innot/Diag6502rp/docs/dev/6502 Varints.odt

# 6502 Pin Compatible Variants

MOS/Rockwell/Synertek | 6502 | 1 MHz
| 6502A | 2 MHz
| 6502B | 3 MHz
| 6502C | 4 MHz
Atari | Sally (6502C) | 1.8 MHz
WDC | W65C02S | 14 MHz

Ma | | | Pin1 | Pin5 | Pin34 | Pin35 | Pin36
6502 | | | VSS (GND) | N.C. | R/W | N.C. | N.C.
Atari Sally | | | VSS (GND) | N.C. | N.C. | HALT | R/W
WDC65C02S | | | VPB | MLB | R/W | N.C. | BE

BE: Bus Enable input When low A, D and R/W are high impedance (async)

HALT: Halt CPU input When low A, D and R/W are high impedance (async)

MLB: Memory Lock output Low during memory read/modify/write cycles.

VPB: Vector Pull output Low when CPU reads interrupt vector

WDC65C02:

- RDY is bidirectional (low output during WAI instruction)
