innot/Diag6502rp/(list of files, drawings)

Other design files:
hardware/Diag6502rp/freerouting.dsn
hardware/Diag6502rp/temp-freerouting.dsn
