innot/Diag6502rp/hardware/Diag6502rp/Diag6502rp.kicad_pcb

## KiCad design hardware/Diag6502rp/Diag6502rp.kicad_pcb (2025-07-18)

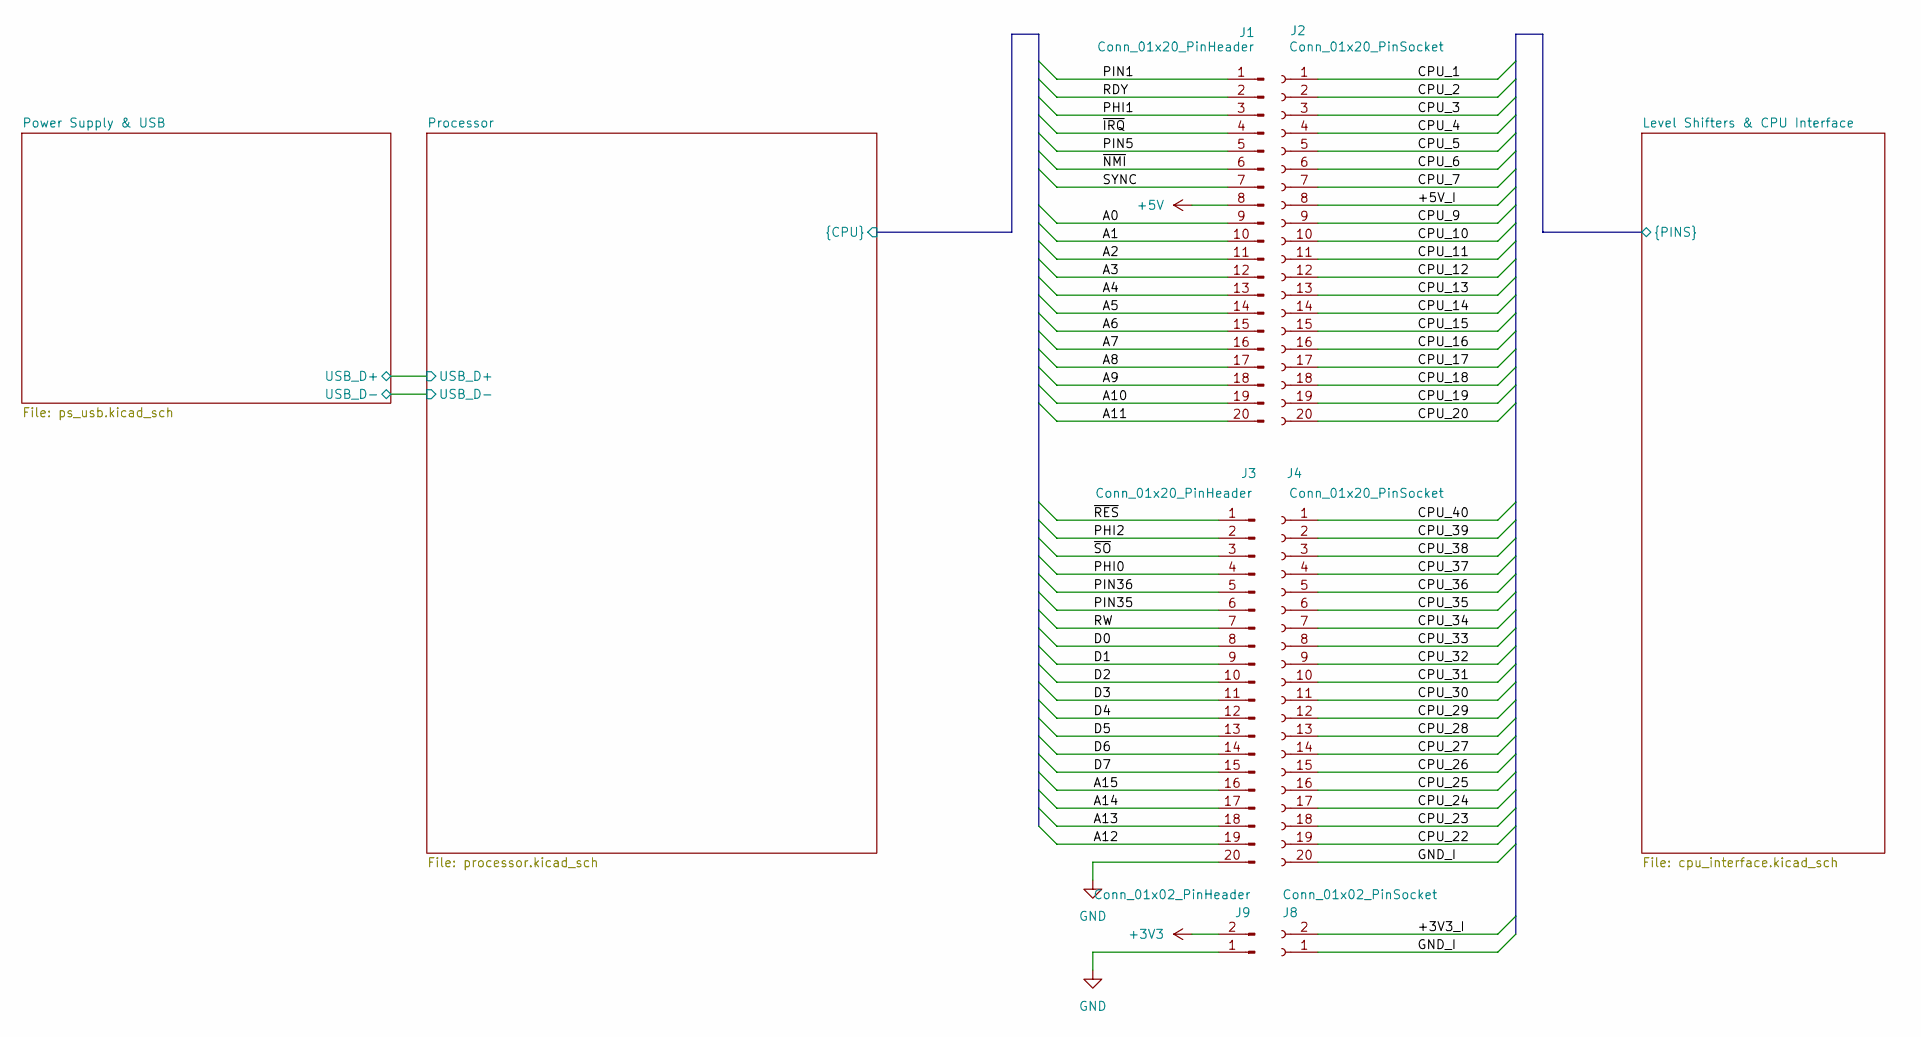
[picture p1: schematic Diag6502rp.kicad_sch]

Parts:
J1, J3: Conn_01x20_PinHeader; PinHeader_1x20_P2.54mm_Vertical; LCSC Part # C50981
J2, J4: Conn_01x20_PinSocket; PinSocket_1x20_P2.54mm_Vertical; LCSC Part # C7499336
J8: Conn_01x02_PinSocket; PinSocket_1x02_P2.54mm_Vertical; LCSC Part # C7499322
J9: Conn_01x02_PinHeader; PinHeader_1x02_P2.54mm_Vertical; LCSC Part # C492401

Connections:
+3V3: J9.2; also elsewhere on the board
+5V: J1.8; also elsewhere on the board
/Level Shifters & CPU Interface/+3V3_I: J8.2; also elsewhere on the board
/Level Shifters & CPU Interface/+5V_I: J2.8; also elsewhere on the board
/Level Shifters & CPU Interface/CPU_1: J2.1; also elsewhere on the board
/Level Shifters & CPU Interface/CPU_2: J2.2; also elsewhere on the board
/Level Shifters & CPU Interface/CPU_3: J2.3; also elsewhere on the board
/Level Shifters & CPU Interface/CPU_4: J2.4; also elsewhere on the board
/Level Shifters & CPU Interface/CPU_5: J2.5; also elsewhere on the board
/Level Shifters & CPU Interface/CPU_6: J2.6; also elsewhere on the board
/Level Shifters & CPU Interface/CPU_7: J2.7; also elsewhere on the board
/Level Shifters & CPU Interface/CPU_9: J2.9; also elsewhere on the board
/Level Shifters & CPU Interface/CPU_10: J2.10; also elsewhere on the board
/Level Shifters & CPU Interface/CPU_11: J2.11; also elsewhere on the board
/Level Shifters & CPU Interface/CPU_12: J2.12; also elsewhere on the board
/Level Shifters & CPU Interface/CPU_13: J2.13; also elsewhere on the board
/Level Shifters & CPU Interface/CPU_14: J2.14; also elsewhere on the board
/Level Shifters & CPU Interface/CPU_15: J2.15; also elsewhere on the board
/Level Shifters & CPU Interface/CPU_16: J2.16; also elsewhere on the board
/Level Shifters & CPU Interface/CPU_17: J2.17; also elsewhere on the board
/Level Shifters & CPU Interface/CPU_18: J2.18; also elsewhere on the board
/Level Shifters & CPU Interface/CPU_19: J2.19; also elsewhere on the board
/Level Shifters & CPU Interface/CPU_20: J2.20; also elsewhere on the board
/Level Shifters & CPU Interface/CPU_22: J4.19; also elsewhere on the board
/Level Shifters & CPU Interface/CPU_23: J4.18; also elsewhere on the board
/Level Shifters & CPU Interface/CPU_24: J4.17; also elsewhere on the board
/Level Shifters & CPU Interface/CPU_25: J4.16; also elsewhere on the board
/Level Shifters & CPU Interface/CPU_26: J4.15; also elsewhere on the board
/Level Shifters & CPU Interface/CPU_27: J4.14; also elsewhere on the board
/Level Shifters & CPU Interface/CPU_28: J4.13; also elsewhere on the board
/Level Shifters & CPU Interface/CPU_29: J4.12; also elsewhere on the board
/Level Shifters & CPU Interface/CPU_30: J4.11; also elsewhere on the board
/Level Shifters & CPU Interface/CPU_31: J4.10; also elsewhere on the board
/Level Shifters & CPU Interface/CPU_32: J4.9; also elsewhere on the board
/Level Shifters & CPU Interface/CPU_33: J4.8; also elsewhere on the board
/Level Shifters & CPU Interface/CPU_34: J4.7; also elsewhere on the board
/Level Shifters & CPU Interface/CPU_35: J4.6; also elsewhere on the board
/Level Shifters & CPU Interface/CPU_36: J4.5; also elsewhere on the board
/Level Shifters & CPU Interface/CPU_37: J4.4; also elsewhere on the board
/Level Shifters & CPU Interface/CPU_38: J4.3; also elsewhere on the board
/Level Shifters & CPU Interface/CPU_39: J4.2; also elsewhere on the board
/Level Shifters & CPU Interface/CPU_40: J4.1; also elsewhere on the board
/Level Shifters & CPU Interface/GND_I: J4.20, J8.1; also elsewhere on the board
/Processor/A0: J1.9; also elsewhere on the board
/Processor/A1: J1.10; also elsewhere on the board
/Processor/A2: J1.11; also elsewhere on the board
/Processor/A3: J1.12; also elsewhere on the board
/Processor/A4: J1.13; also elsewhere on the board
/Processor/A5: J1.14; also elsewhere on the board
/Processor/A6: J1.15; also elsewhere on the board
/Processor/A7: J1.16; also elsewhere on the board
/Processor/A8: J1.17; also elsewhere on the board
/Processor/A9: J1.18; also elsewhere on the board
/Processor/A10: J1.19; also elsewhere on the board
/Processor/A11: J1.20; also elsewhere on the board
/Processor/A12: J3.19; also elsewhere on the board
/Processor/A13: J3.18; also elsewhere on the board
/Processor/A14: J3.17; also elsewhere on the board
/Processor/A15: J3.16; also elsewhere on the board
/Processor/D0: J3.8; also elsewhere on the board
/Processor/D1: J3.9; also elsewhere on the board
/Processor/D2: J3.10; also elsewhere on the board
/Processor/D3: J3.11; also elsewhere on the board
/Processor/D4: J3.12; also elsewhere on the board
/Processor/D5: J3.13; also elsewhere on the board
/Processor/D6: J3.14; also elsewhere on the board
/Processor/D7: J3.15; also elsewhere on the board
/Processor/PHI0: J3.4; also elsewhere on the board
/Processor/PHI1: J1.3; also elsewhere on the board
/Processor/PHI2: J3.2; also elsewhere on the board
/Processor/PIN1: J1.1; also elsewhere on the board
/Processor/PIN5: J1.5; also elsewhere on the board
/Processor/PIN35: J3.6; also elsewhere on the board
/Processor/PIN36: J3.5; also elsewhere on the board
/Processor/RDY: J1.2; also elsewhere on the board
/Processor/RW: J3.7; also elsewhere on the board
/Processor/SYNC: J1.7; also elsewhere on the board
/Processor/~IRQ: J1.4; also elsewhere on the board
/Processor/~NMI: J1.6; also elsewhere on the board
/Processor/~RES: J3.1; also elsewhere on the board
/Processor/~SO: J3.3; also elsewhere on the board
GND: J3.20, J9.1; also elsewhere on the board

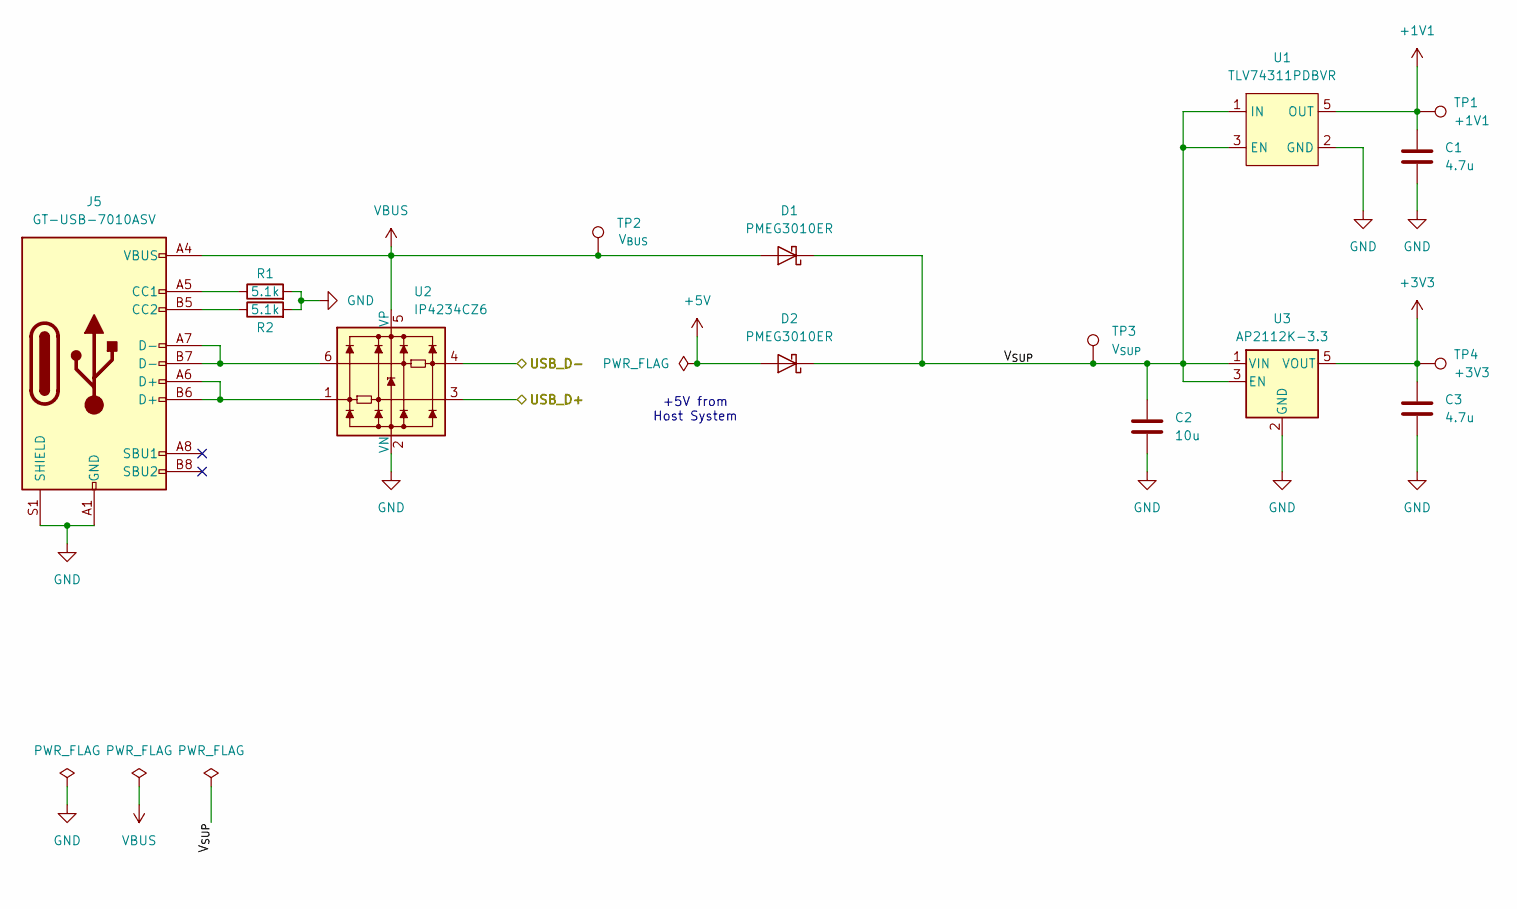
[picture p2: schematic ps_usb.kicad_sch]

Parts:
C1, C3: 4.7u; C_0402_1005Metric; LCSC Part # C23733
C2: 10u; C_0603_1608Metric; LCSC Part # C19702
D1, D2: PMEG3010ER; Nexperia_CFP3_SOD-123W; LCSC Part # C456106
J5: GT-USB-7010ASV; USB_C_Receptacle_G-Switch_GT-USB-7010ASV
R1, R2: 5.1k; R_0402_1005Metric; LCSC Part # C25905
TP1: +1V1; TestPoint_Pad_1.0x1.0mm
TP2: V_{BUS}; TestPoint_Pad_1.0x1.0mm
TP3: V_{SUP}; TestPoint_Pad_1.0x1.0mm
TP4: +3V3; TestPoint_Pad_1.0x1.0mm
U1: TLV74311PDBVR; SOT-23-5; LCSC Part # C485147
U2: IP4234CZ6; SC-74-6_1.55x2.9mm_P0.95mm; LCSC Part # C455086
U3: AP2112K-3.3; SOT-23-5; LCSC Part # C51118

Connections:
+1V1: C1.1, TP1.1, U1.5 (OUT); also elsewhere on the board
+3V3: C3.1, TP4.1, U3.5 (VOUT); also elsewhere on the board
+5V: D2.2 (A); also elsewhere on the board
/Power Supply & USB/V_{SUP}: C2.1, D1.1 (K), D2.1 (K), TP3.1, U1.1 (IN), U1.3 (EN), U3.1 (VIN), U3.3 (EN)
/Processor/USB_D+: U2.3; also elsewhere on the board
/Processor/USB_D-: U2.4; also elsewhere on the board
GND: C1.2, C2.2, C3.2, J5.A1 (GND), J5.A12 (GND), J5.B1 (GND), J5.B12 (GND), J5.S1 (SHIELD), R1.2, R2.2, U1.2 (GND), U2.2 (VN), U3.2 (GND); also elsewhere on the board
unnamed: J5.A5 (CC1), R1.1
unnamed: J5.B5 (CC2), R2.1
unnamed: J5.A6 (D+), J5.B6 (D+), U2.1
unnamed: J5.A7 (D-), J5.B7 (D-), U2.6
VBUS: D1.2 (A), J5.A4 (VBUS), J5.A9 (VBUS), J5.B4 (VBUS), J5.B9 (VBUS), TP2.1, U2.5 (VP)

Notes on the sheet:
+5V from Host System

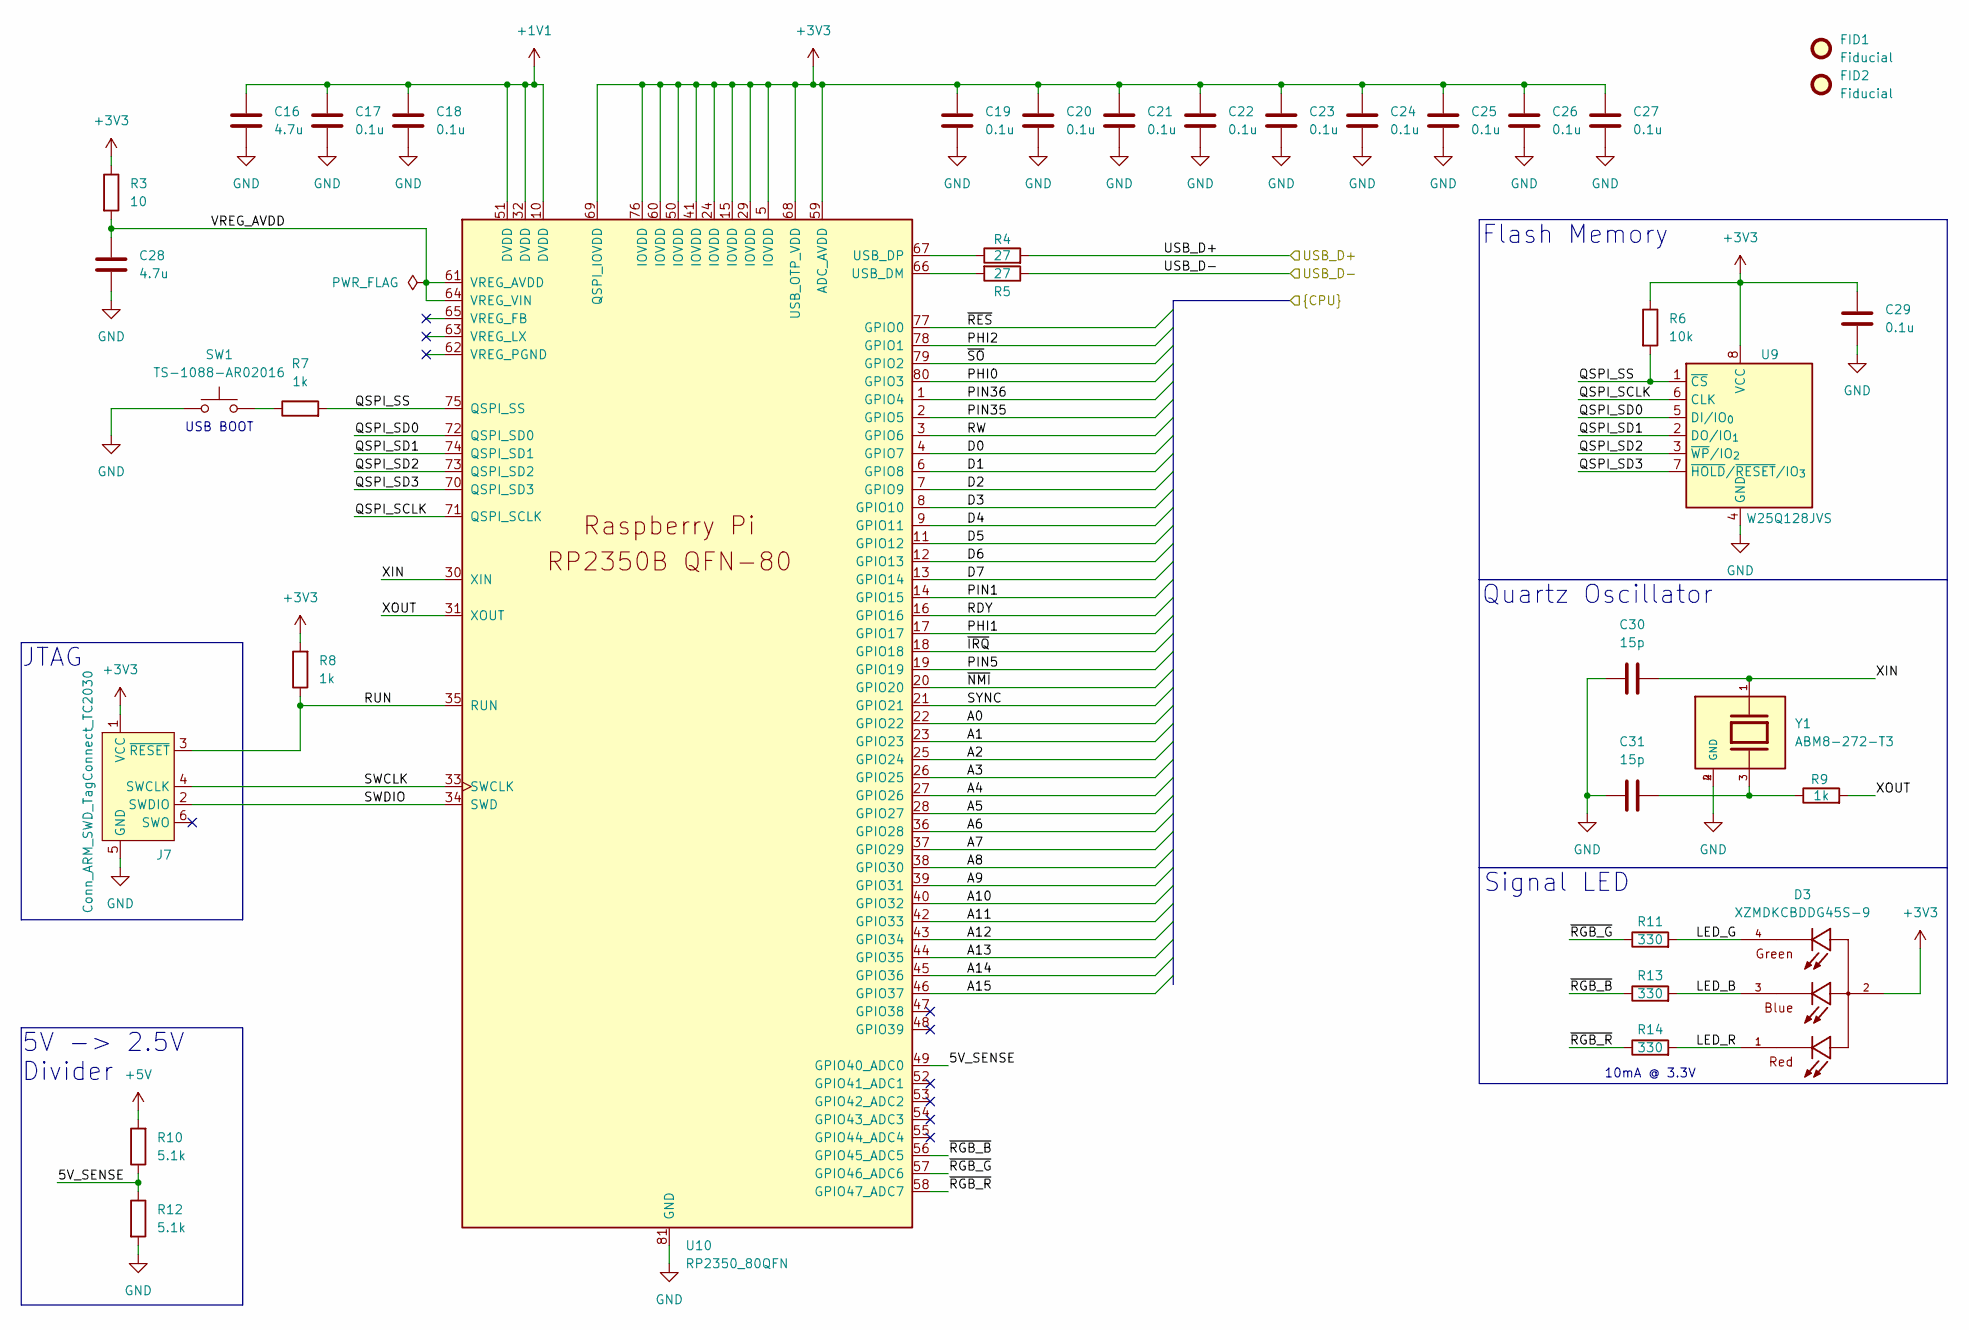
[picture p3: schematic processor.kicad_sch]

Parts:
C16, C28: 4.7u; C_0402_1005Metric; LCSC Part # C23733
C17, C18, C19, C20, C21, C22, C23, C24, C25, C26, C27, C29: 0.1u; C_0402_1005Metric; LCSC Part # C1525
C30, C31: 15p; C_0402_1005Metric; LCSC Part # C1548
D3: XZMDKCBDDG45S-9; LED_XZMDKCBDDG45S-9; PARTREV V11-Z; DigiKey_Part_Number 1497-1257-2-ND
FID1, FID2: Fiducial; Fiducial_1mm_Mask2mm
J7: Conn_ARM_SWD_TagConnect_TC2030; Tag-Connect_TC2030-IDC-FP_2x03_P1.27mm_Vertical
R3: 10; R_0402_1005Metric; LCSC Part # C25077
R4, R5: 27; R_0402_1005Metric; LCSC Part # C138021
R6: 10k; R_0402_1005Metric; LCSC Part # C25744
R7, R8, R9: 1k; R_0402_1005Metric; LCSC Part # C11702
R10, R12: 5.1k; R_0402_1005Metric; LCSC Part # C25905
R11, R13, R14: 330; R_0402_1005Metric; LCSC Part # C25130
SW1: TS-1088-AR02016; TS-1088-xxxxxxx; LCSC Part # C720477
U9: W25Q128JVS; SOIC-8_5.3x5.3mm_P1.27mm; LCSC Part # C97521
U10: RP2350_80QFN; RP2350-QFN-80-1EP_10x10_P0.4mm_EP3.4x3.4mm_ThermalVias; LCSC Part # C42415655
Y1: ABM8-272-T3; XTAL_ABM8-272-T3; PARTREV 07-29-20; LCSC Part # C20625731

Connections:
+1V1: C16.1, C17.1, C18.1, U10.10 (DVDD), U10.32 (DVDD), U10.51 (DVDD); also elsewhere on the board
+3V3: C19.1, C20.1, C21.1, C22.1, C23.1, C24.1, C25.1, C26.1, C27.1, C29.1, D3.2, J7.1 (VCC), R3.1, R6.1, R8.2, U9.8 (VCC), U10.5 (IOVDD), U10.15 (IOVDD), U10.24 (IOVDD), U10.29 (IOVDD), U10.41 (IOVDD), U10.50 (IOVDD), U10.59 (ADC_AVDD), U10.60 (IOVDD), U10.68 (USB_OTP_VDD), U10.69 (QSPI_IOVDD), U10.76 (IOVDD); also elsewhere on the board
+5V: R10.2; also elsewhere on the board
/Processor/5V_SENSE: R10.1, R12.1, U10.49 (GPIO40_ADC0)
/Processor/A0: U10.22 (GPIO22); also elsewhere on the board
/Processor/A1: U10.23 (GPIO23); also elsewhere on the board
/Processor/A2: U10.25 (GPIO24); also elsewhere on the board
/Processor/A3: U10.26 (GPIO25); also elsewhere on the board
/Processor/A4: U10.27 (GPIO26); also elsewhere on the board
/Processor/A5: U10.28 (GPIO27); also elsewhere on the board
/Processor/A6: U10.36 (GPIO28); also elsewhere on the board
/Processor/A7: U10.37 (GPIO29); also elsewhere on the board
/Processor/A8: U10.38 (GPIO30); also elsewhere on the board
/Processor/A9: U10.39 (GPIO31); also elsewhere on the board
/Processor/A10: U10.40 (GPIO32); also elsewhere on the board
/Processor/A11: U10.42 (GPIO33); also elsewhere on the board
/Processor/A12: U10.43 (GPIO34); also elsewhere on the board
/Processor/A13: U10.44 (GPIO35); also elsewhere on the board
/Processor/A14: U10.45 (GPIO36); also elsewhere on the board
/Processor/A15: U10.46 (GPIO37); also elsewhere on the board
/Processor/D0: U10.4 (GPIO7); also elsewhere on the board
/Processor/D1: U10.6 (GPIO8); also elsewhere on the board
/Processor/D2: U10.7 (GPIO9); also elsewhere on the board
/Processor/D3: U10.8 (GPIO10); also elsewhere on the board
/Processor/D4: U10.9 (GPIO11); also elsewhere on the board
/Processor/D5: U10.11 (GPIO12); also elsewhere on the board
/Processor/D6: U10.12 (GPIO13); also elsewhere on the board
/Processor/D7: U10.13 (GPIO14); also elsewhere on the board
/Processor/LED_B: D3.3, R13.2
/Processor/LED_G: D3.4, R11.2
/Processor/LED_R: D3.1, R14.2
/Processor/PHI0: U10.80 (GPIO3); also elsewhere on the board
/Processor/PHI1: U10.17 (GPIO17); also elsewhere on the board
/Processor/PHI2: U10.78 (GPIO1); also elsewhere on the board
/Processor/PIN1: U10.14 (GPIO15); also elsewhere on the board
/Processor/PIN5: U10.19 (GPIO19); also elsewhere on the board
/Processor/PIN35: U10.2 (GPIO5); also elsewhere on the board
/Processor/PIN36: U10.1 (GPIO4); also elsewhere on the board
/Processor/QSPI_SCLK: U9.6 (CLK), U10.71 (QSPI_SCLK)
/Processor/QSPI_SD0: U9.5 (DI/IO_{0}), U10.72 (QSPI_SD0)
/Processor/QSPI_SD1: U9.2 (DO/IO_{1}), U10.74 (QSPI_SD1)
/Processor/QSPI_SD2: U9.3 (~WP/IO_{2}), U10.73 (QSPI_SD2)
/Processor/QSPI_SD3: U9.7 (~HOLD/~RESET/IO_{3}), U10.70 (QSPI_SD3)
/Processor/QSPI_SS: R6.2, R7.2, U9.1 (~CS), U10.75 (QSPI_SS)
/Processor/RDY: U10.16 (GPIO16); also elsewhere on the board
/Processor/RUN: J7.3 (~RESET), R8.1, U10.35 (RUN)
/Processor/RW: U10.3 (GPIO6); also elsewhere on the board
/Processor/SWCLK: J7.4 (SWCLK), U10.33 (SWCLK)
/Processor/SWDIO: J7.2 (SWDIO), U10.34 (SWD)
/Processor/SYNC: U10.21 (GPIO21); also elsewhere on the board
/Processor/USB_D+: R4.2; also elsewhere on the board
/Processor/USB_D-: R5.1; also elsewhere on the board
/Processor/VREG_AVDD: C28.1, R3.2, U10.61 (VREG_AVDD), U10.64 (VREG_VIN)
/Processor/XIN: C30.2, U10.30 (XIN), Y1.1
/Processor/XOUT: R9.2, U10.31 (XOUT)
/Processor/~IRQ: U10.18 (GPIO18); also elsewhere on the board
/Processor/~NMI: U10.20 (GPIO20); also elsewhere on the board
/Processor/~RES: U10.77 (GPIO0); also elsewhere on the board
/Processor/~RGB_B: R13.1, U10.56 (GPIO45_ADC5)
/Processor/~RGB_G: R11.1, U10.57 (GPIO46_ADC6)
/Processor/~RGB_R: R14.1, U10.58 (GPIO47_ADC7)
/Processor/~SO: U10.79 (GPIO2); also elsewhere on the board
GND: C16.2, C17.2, C18.2, C19.2, C20.2, C21.2, C22.2, C23.2, C24.2, C25.2, C26.2, C27.2, C28.2, C29.2, C30.1, C31.1, J7.5 (GND), R12.2, SW1.1, U9.4 (GND), U10.81 (GND), Y1.2 (GND), Y1.4 (GND); also elsewhere on the board
unnamed: C31.2, R9.1, Y1.3
unnamed: R7.1, SW1.2
unnamed: R5.2, U10.66 (USB_DM)
unnamed: R4.1, U10.67 (USB_DP)

Notes on the sheet:
10mA @ 3.3V
5V -> 2.5V Divider
USB BOOT
Signal LED
JTAG
Quartz Oscillator
Flash Memory

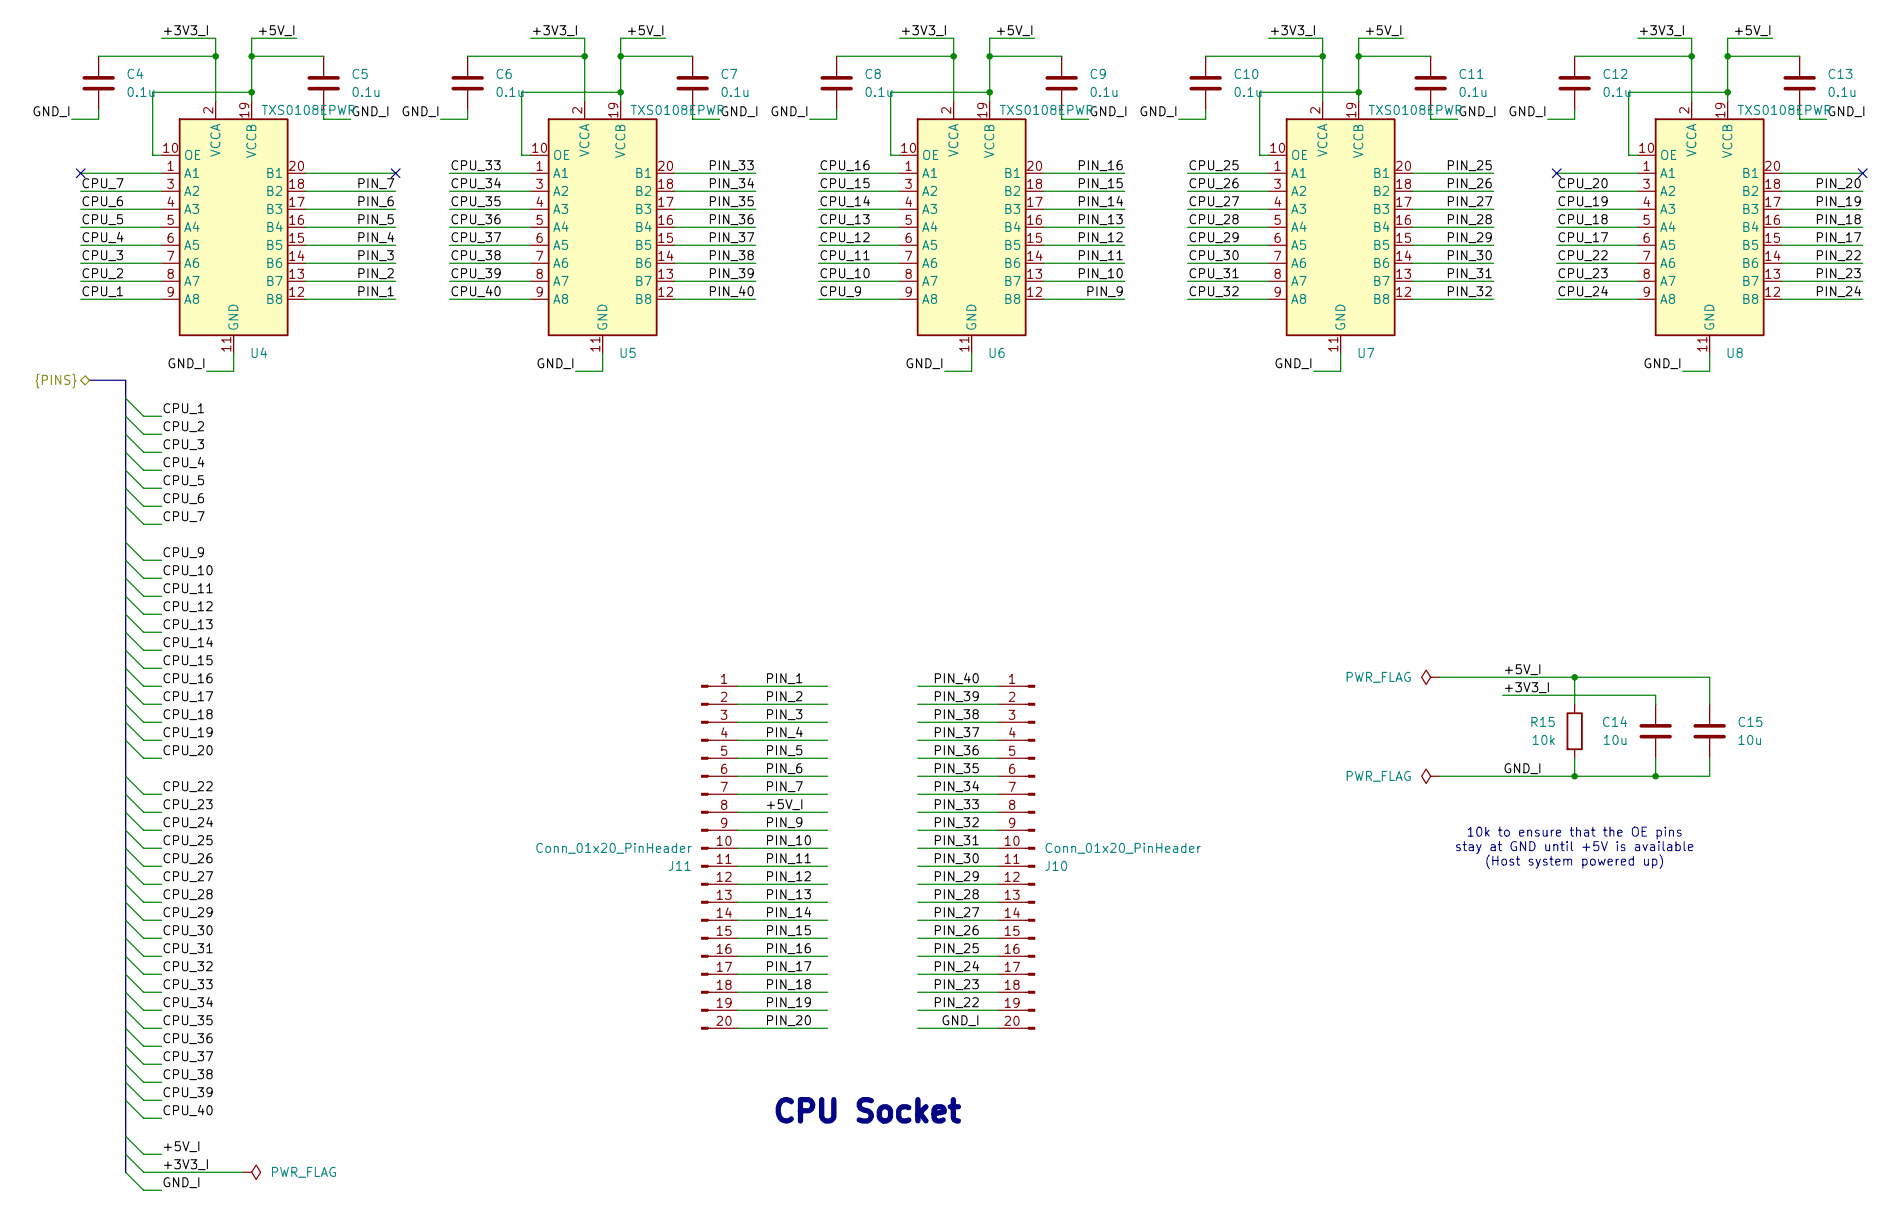
[picture p4: schematic cpu_interface.kicad_sch]

Parts:
C4, C5, C6, C7, C8, C9, C10, C11, C12, C13: 0.1u; C_0402_1005Metric; LCSC Part # C1525
C14, C15: 10u; C_0603_1608Metric; LCSC Part # C19702
J10, J11: Conn_01x20_PinHeader; PinHeader_1x20_P2.54mm_Vertical; LCSC Part # C50981
R15: 10k; R_0402_1005Metric; LCSC Part # C25744
U4, U5, U6, U7, U8: TXS0108EPWR; TSSOP-20_4.4x6.5mm_P0.65mm; LCSC Part # C17206

Connections:
/Level Shifters & CPU Interface/+3V3_I: C4.1, C6.1, C8.1, C10.1, C12.1, C14.1, U4.2 (VCCA), U5.2 (VCCA), U6.2 (VCCA), U7.2 (VCCA), U8.2 (VCCA); also elsewhere on the board
/Level Shifters & CPU Interface/+5V_I: C5.1, C7.1, C9.1, C11.1, C13.1, C15.1, J11.8, R15.1, U4.10 (OE), U4.19 (VCCB), U5.10 (OE), U5.19 (VCCB), U6.10 (OE), U6.19 (VCCB), U7.10 (OE), U7.19 (VCCB), U8.10 (OE), U8.19 (VCCB); also elsewhere on the board
/Level Shifters & CPU Interface/CPU_1: U4.9 (A8); also elsewhere on the board
/Level Shifters & CPU Interface/CPU_2: U4.8 (A7); also elsewhere on the board
/Level Shifters & CPU Interface/CPU_3: U4.7 (A6); also elsewhere on the board
/Level Shifters & CPU Interface/CPU_4: U4.6 (A5); also elsewhere on the board
/Level Shifters & CPU Interface/CPU_5: U4.5 (A4); also elsewhere on the board
/Level Shifters & CPU Interface/CPU_6: U4.4 (A3); also elsewhere on the board
/Level Shifters & CPU Interface/CPU_7: U4.3 (A2); also elsewhere on the board
/Level Shifters & CPU Interface/CPU_9: U6.9 (A8); also elsewhere on the board
/Level Shifters & CPU Interface/CPU_10: U6.8 (A7); also elsewhere on the board
/Level Shifters & CPU Interface/CPU_11: U6.7 (A6); also elsewhere on the board
/Level Shifters & CPU Interface/CPU_12: U6.6 (A5); also elsewhere on the board
/Level Shifters & CPU Interface/CPU_13: U6.5 (A4); also elsewhere on the board
/Level Shifters & CPU Interface/CPU_14: U6.4 (A3); also elsewhere on the board
/Level Shifters & CPU Interface/CPU_15: U6.3 (A2); also elsewhere on the board
/Level Shifters & CPU Interface/CPU_16: U6.1 (A1); also elsewhere on the board
/Level Shifters & CPU Interface/CPU_17: U8.6 (A5); also elsewhere on the board
/Level Shifters & CPU Interface/CPU_18: U8.5 (A4); also elsewhere on the board
/Level Shifters & CPU Interface/CPU_19: U8.4 (A3); also elsewhere on the board
/Level Shifters & CPU Interface/CPU_20: U8.3 (A2); also elsewhere on the board
/Level Shifters & CPU Interface/CPU_22: U8.7 (A6); also elsewhere on the board
/Level Shifters & CPU Interface/CPU_23: U8.8 (A7); also elsewhere on the board
/Level Shifters & CPU Interface/CPU_24: U8.9 (A8); also elsewhere on the board
/Level Shifters & CPU Interface/CPU_25: U7.1 (A1); also elsewhere on the board
/Level Shifters & CPU Interface/CPU_26: U7.3 (A2); also elsewhere on the board
/Level Shifters & CPU Interface/CPU_27: U7.4 (A3); also elsewhere on the board
/Level Shifters & CPU Interface/CPU_28: U7.5 (A4); also elsewhere on the board
/Level Shifters & CPU Interface/CPU_29: U7.6 (A5); also elsewhere on the board
/Level Shifters & CPU Interface/CPU_30: U7.7 (A6); also elsewhere on the board
/Level Shifters & CPU Interface/CPU_31: U7.8 (A7); also elsewhere on the board
/Level Shifters & CPU Interface/CPU_32: U7.9 (A8); also elsewhere on the board
/Level Shifters & CPU Interface/CPU_33: U5.1 (A1); also elsewhere on the board
/Level Shifters & CPU Interface/CPU_34: U5.3 (A2); also elsewhere on the board
/Level Shifters & CPU Interface/CPU_35: U5.4 (A3); also elsewhere on the board
/Level Shifters & CPU Interface/CPU_36: U5.5 (A4); also elsewhere on the board
/Level Shifters & CPU Interface/CPU_37: U5.6 (A5); also elsewhere on the board
/Level Shifters & CPU Interface/CPU_38: U5.7 (A6); also elsewhere on the board
/Level Shifters & CPU Interface/CPU_39: U5.8 (A7); also elsewhere on the board
/Level Shifters & CPU Interface/CPU_40: U5.9 (A8); also elsewhere on the board
/Level Shifters & CPU Interface/GND_I: C4.2, C5.2, C6.2, C7.2, C8.2, C9.2, C10.2, C11.2, C12.2, C13.2, C14.2, C15.2, J10.20, R15.2, U4.11 (GND), U5.11 (GND), U6.11 (GND), U7.11 (GND), U8.11 (GND); also elsewhere on the board
/Level Shifters & CPU Interface/PIN_1: J11.1, U4.12 (B8)
/Level Shifters & CPU Interface/PIN_2: J11.2, U4.13 (B7)
/Level Shifters & CPU Interface/PIN_3: J11.3, U4.14 (B6)
/Level Shifters & CPU Interface/PIN_4: J11.4, U4.15 (B5)
/Level Shifters & CPU Interface/PIN_5: J11.5, U4.16 (B4)
/Level Shifters & CPU Interface/PIN_6: J11.6, U4.17 (B3)
/Level Shifters & CPU Interface/PIN_7: J11.7, U4.18 (B2)
/Level Shifters & CPU Interface/PIN_9: J11.9, U6.12 (B8)
/Level Shifters & CPU Interface/PIN_10: J11.10, U6.13 (B7)
/Level Shifters & CPU Interface/PIN_11: J11.11, U6.14 (B6)
/Level Shifters & CPU Interface/PIN_12: J11.12, U6.15 (B5)
/Level Shifters & CPU Interface/PIN_13: J11.13, U6.16 (B4)
/Level Shifters & CPU Interface/PIN_14: J11.14, U6.17 (B3)
/Level Shifters & CPU Interface/PIN_15: J11.15, U6.18 (B2)
/Level Shifters & CPU Interface/PIN_16: J11.16, U6.20 (B1)
/Level Shifters & CPU Interface/PIN_17: J11.17, U8.15 (B5)
/Level Shifters & CPU Interface/PIN_18: J11.18, U8.16 (B4)
/Level Shifters & CPU Interface/PIN_19: J11.19, U8.17 (B3)
/Level Shifters & CPU Interface/PIN_20: J11.20, U8.18 (B2)
/Level Shifters & CPU Interface/PIN_22: J10.19, U8.14 (B6)
/Level Shifters & CPU Interface/PIN_23: J10.18, U8.13 (B7)
/Level Shifters & CPU Interface/PIN_24: J10.17, U8.12 (B8)
/Level Shifters & CPU Interface/PIN_25: J10.16, U7.20 (B1)
/Level Shifters & CPU Interface/PIN_26: J10.15, U7.18 (B2)
/Level Shifters & CPU Interface/PIN_27: J10.14, U7.17 (B3)
/Level Shifters & CPU Interface/PIN_28: J10.13, U7.16 (B4)
/Level Shifters & CPU Interface/PIN_29: J10.12, U7.15 (B5)
/Level Shifters & CPU Interface/PIN_30: J10.11, U7.14 (B6)
/Level Shifters & CPU Interface/PIN_31: J10.10, U7.13 (B7)
/Level Shifters & CPU Interface/PIN_32: J10.9, U7.12 (B8)
/Level Shifters & CPU Interface/PIN_33: J10.8, U5.20 (B1)
/Level Shifters & CPU Interface/PIN_34: J10.7, U5.18 (B2)
/Level Shifters & CPU Interface/PIN_35: J10.6, U5.17 (B3)
/Level Shifters & CPU Interface/PIN_36: J10.5, U5.16 (B4)
/Level Shifters & CPU Interface/PIN_37: J10.4, U5.15 (B5)
/Level Shifters & CPU Interface/PIN_38: J10.3, U5.14 (B6)
/Level Shifters & CPU Interface/PIN_39: J10.2, U5.13 (B7)
/Level Shifters & CPU Interface/PIN_40: J10.1, U5.12 (B8)

Notes on the sheet:
10k to ensure that the OE pins stay at GND until +5V is available (Host system powered up)
CPU Socket

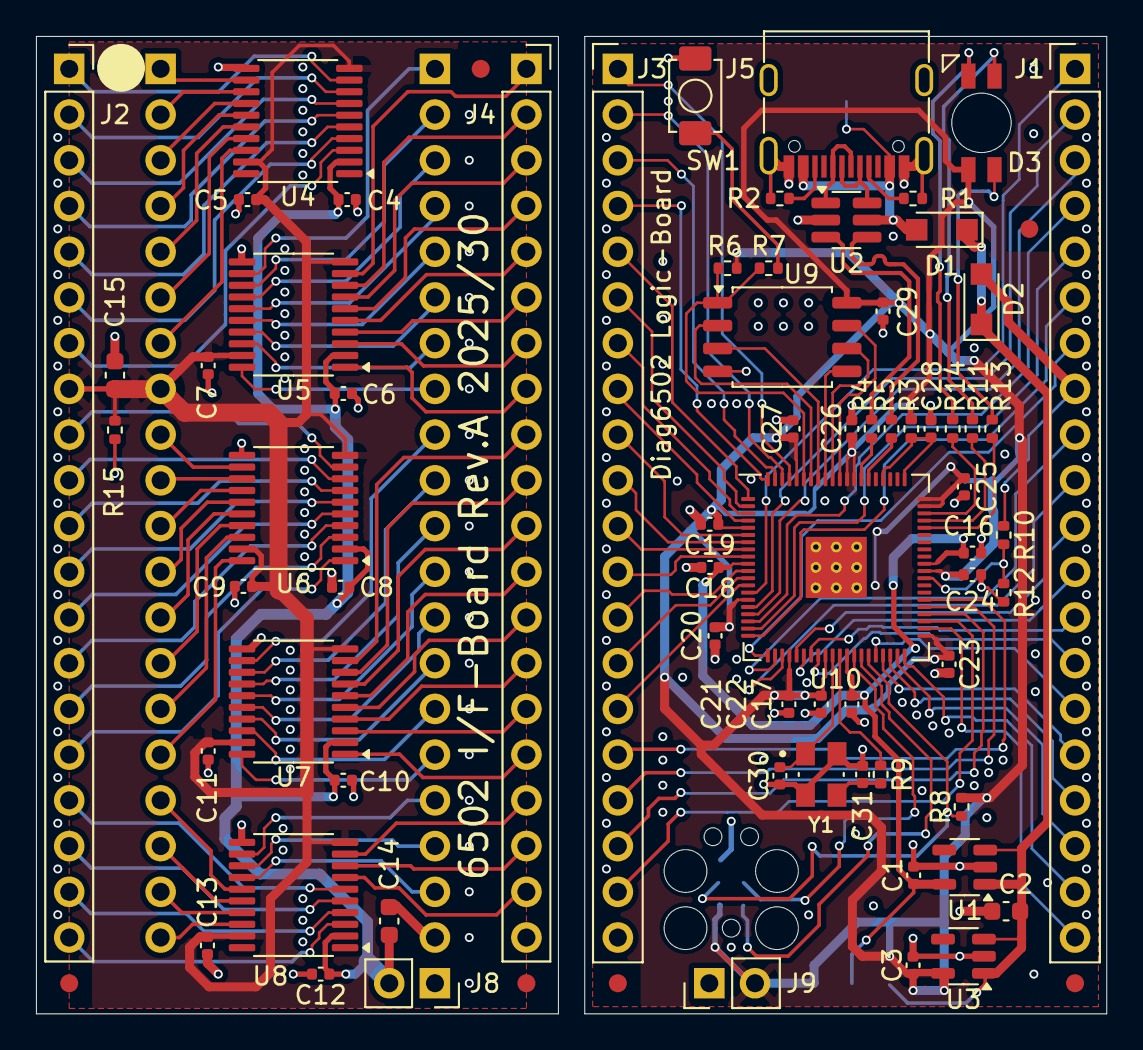
[picture p5: board Diag6502rp.kicad_pcb from above]

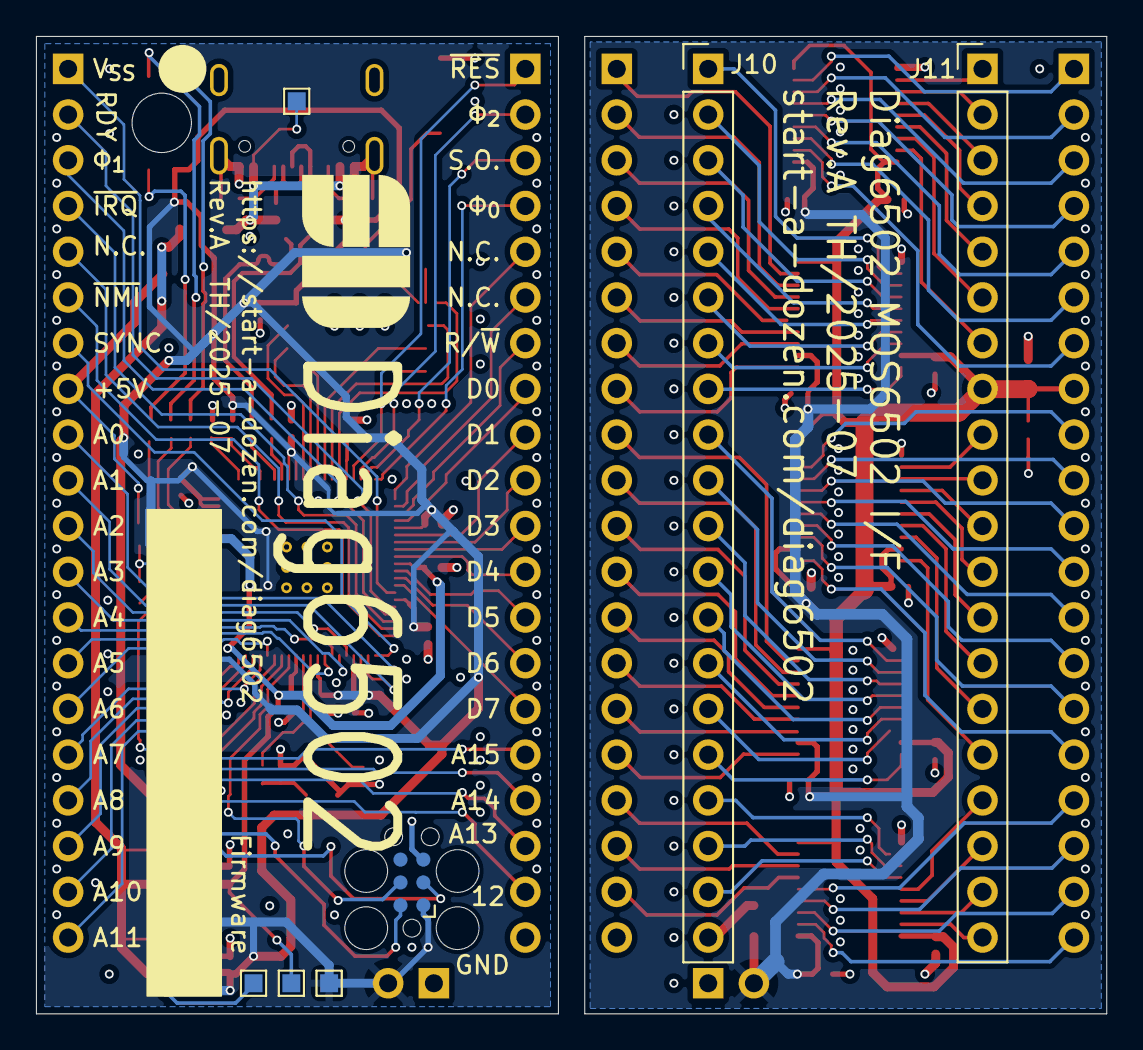
[picture p6: board Diag6502rp.kicad_pcb from below]

Board: 4 copper layers, 59.5 x 54.3 mm, 83 parts (7 on the bottom side), 152 nets.

Other parts of the board:
B1, B2: Board
FID3, FID4, FID5, FID6: Fiducial_1mm_Mask2mm
