innot/Diag6502rp/(commit log)

2025-07-06 Changed TSX0108e foorprint to TSSOP20 for easier routing.
    [Diag6502rp.kicad_pcb, Diag6502rp.kicad_sch, cpu_interface.kicad_sch, processor.kicad_sch, ps_usb.kicad_sch]
2025-07-06 Main design completed
    [Diag6502rp.kicad_pcb, Diag6502rp.kicad_sch, Diag6502rp_left.kicad_pcb, Diag6502rp_right.kicad_pcb, cpu_interface.kicad_sch, processor.kicad_sch, ps_usb.kicad_sch]
2025-07-07 Cleanup, Fiduciaries, component spacing
    [6502_if_board.kicad_pcb, Diag6502rp.kicad_pcb, Diag6502rp.kicad_sch, bom.csv, cpu_interface.kicad_sch, designators.csv, if_board.kicad_pcb, positions.csv]
2025-07-07 preparing for assembly
    [6502_if_board.kicad_pcb, Diag6502rp.kicad_pcb, bom.csv, designators.csv, if_board.kicad_pcb, positions.csv, processor.kicad_sch, ps_usb.kicad_sch]
2025-07-12 Added transfer and stitching vias.
    [processor.kicad_sch, ps_usb.kicad_sch]
2025-07-14 More via separation and transfer vias
    [Diag6502rp.kicad_pcb, cpu_interface.kicad_sch, if-board.kicad_pcb, ps_usb.kicad_sch]
